bkeegs/Mixtape-Board/mixtape_layout.PNG

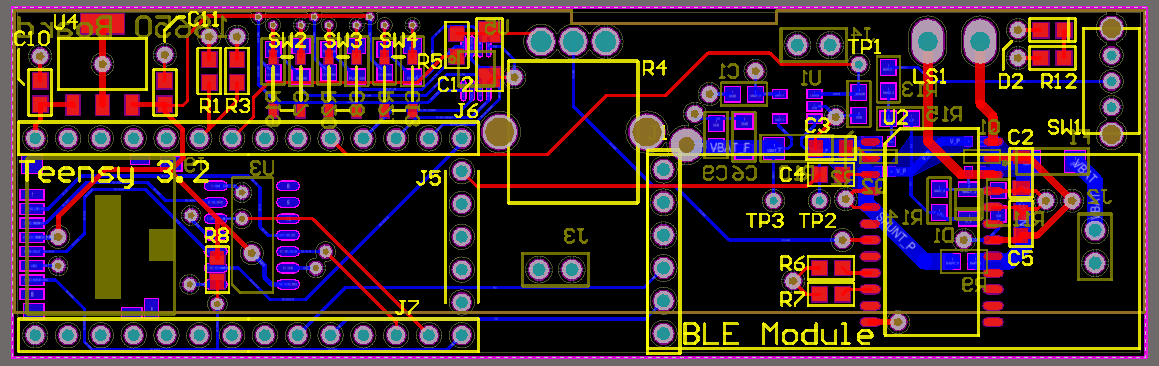
mixtape_layout.PNG
