bkeegs/Mixtape-Board/PDF_and_BOM/mixtape_BOM.xlsx

Description | Designator | LibRef | Manufacturer 1 | Manufacturer Part Number 1 | Quantity | Supplier Part Number 1
CAP CER 0.1UF 16V X7R 0603 | C1, C5 | CC0603KRX7R7BB104 | Yageo | CC0603KRX7R7BB104 | 2 | 311-1088-1-ND
CAP CER 10UF 25V X5R 0805 | C2, C6, C7, C8, C13 | GRM21BR61E106KA73L | Murata Electronics North America | GRM21BR61E106KA73L | 5 | 490-5523-1-ND
CAP CER 2.2UF 10V X7R 0805 | C3 | C0805C225K8RACTU | Kemet | C0805C225K8RACTU | 1 | 399-3522-1-ND
CAP CER 1UF 25V X5R 0603 | C4, C10, C11 | CL10A105KA8NNNC | Samsung Electro-Mechanics America, Inc. | CL10A105KA8NNNC | 3 | 1276-1102-1-ND
CAP CER 100PF 25V NP0 0201 | C9 | GRM0335C1E101JA01D | Murata Electronics North America | GRM0335C1E101JA01D | 1 | 490-3160-1-ND
CAP CER 100UF 6.3V X6T 1206 | C12 | GRM31CD80J107ME39L | Murata Electronics North America | GRM31CD80J107ME39L | 1 | 490-10525-1-ND
DIODE ZENER 3V 200MW SMINI2 | D1 | DZ2J030M0L | Panasonic Electronic Components | DZ2J030M0L | 1 | DZ2J030M0LCT-ND
LED GREEN CLEAR 0603 SMD | D2 | LTST-C191KGKT | Lite-On Inc. | LTST-C191KGKT | 1 | 160-1446-2-ND
FUSE BOARD MOUNT 3A 125VAC 63VDC | F1 | C1Q 3 | Bel Fuse Inc. | C1Q 3 | 1 | 507-1082-1-ND
CONN HEADER FEMALE 6POS .1" TIN | J1 | PPTC061LFBN-RC | Sullins Connector Solutions | PPTC061LFBN-RC | 1 | S7004-ND
CONN HEADER VERT SGL 2POS GOLD | J2, J3, J4 | 961102-6404-AR | 3M | 961102-6404-AR | 3 | 3M9447-ND
SOCKET 7 MM SOLDER TAIL SINGLE | J5 | HEADER TEENSY B | Preci-Dip | 801-87-005-10-001101 | 1 | 1212-1183-ND
SOCKET 7 MM SOLDER TAIL SINGLE | J6 | HEADER TEENSY C | Preci-Dip | 801-87-014-10-001101 | 1 | 1212-1201-ND
SOCKET 7 MM SOLDER TAIL SINGLE | J7 | HEADER TEENSY A | Preci-Dip | 801-87-014-10-001101 | 1 | 1212-1201-ND
CONN MICRO SD CARD PUSH-PULL | J9 | DM3D-SF | Hirose Electric Co Ltd | DM3D-SF | 1 | HR1941CT-ND
SPEAKER 4 OHM 3W 86DB 71X41MM | LS1 | AS07104PO-R | PUI Audio, Inc. | AS07104PO-R | 1 | 668-1216-ND
MOSFET P-CH 20V 8A 6-TSOP | Q1, Q2 | SI3407DV-T1-GE3 | Vishay Siliconix | SI3407DV-T1-GE3 | 2 | SI3407DV-T1-GE3CT-ND
RES SMD 49.9K OHM 1% 1/10W 0603 | R1 | RC0603FR-0749K9L | Yageo | RC0603FR-0749K9L | 1 | 311-49.9KHRCT-ND
RES SMD 100K OHM 1% 1/10W 0603 | R2, R11, R14, R15 | RC0603FR-07100KL | Yageo | RC0603FR-07100KL | 4 | 311-100KHRCT-ND
RES SMD 120K OHM 1% 1/10W 0603 | R3 | RC0603FR-07120KL | Yageo | RC0603FR-07120KL | 1 | 311-120KHRCT-ND
POT 20K OHM 1/20W CARBON LOG | R4 | PTV09A-4025F-A203 | Bourns Inc. | PTV09A-4025F-A203 | 1 | PTV09A-4025F-A203-ND
RES SMD 499 OHM 1% 1/10W 0603 | R5 | RC0603FR-07499RL | Yageo | RC0603FR-07499RL | 1 | 311-499HRCT-ND
RES SMD 4.99K OHM 1% 1/10W 0603 | R6, R7 | ERJ-3EKF4991V | Panasonic Electronic Components | ERJ-3EKF4991V | 2 | P4.99KHCT-ND
RES SMD 10K OHM 5% 1/10W 0603 | R8 | RC0603JR-0710KL | Yageo | RC0603JR-0710KL | 1 | 311-10KGRCT-ND
RES SMD 0.0OHM JUMPER 1/10W 0603 | R9 | RC0603JR-070RL | Yageo | RC0603JR-070RL | 1 | 311-0.0GRCT-ND
RES SMD 0.02 OHM 1% 1W 1206 | R10 | ERJ-8CWFR020V | Panasonic Electronic Components | ERJ-8CWFR020V | 1 | P0.02BVCT-ND
RES SMD 110 OHM 1% 1/10W 0603 | R12 | RC0603FR-07110RL | Yageo | RC0603FR-07110RL | 1 | 311-110HRCT-ND
RES SMD 3.3K OHM 1% 1/10W 0603 | R13, R19, R20, R21 | RC0603FR-073K3L | Yageo | RC0603FR-073K3L | 4 | 311-3.30KHRCT-ND
SWITCH SLIDE SPDT 100MA 12V | SW1 | OS102011MA1QN1 | C&K Components | OS102011MA1QN1 | 1 | CKN9559-ND
SWITCH TACTILE SPST-NO 0.05A 16V | SW2, SW3, SW4 | PTS810 SJM 250 SMTR LFS | C&K | PTS810 SJM 250 SMTR LFS | 3 | CKN10502CT-ND
IC CURRENT MONITOR 0.5% SOT23-5 | U1 | INA138NA/250 | Texas Instruments | INA138NA/250 | 1 | INA138NACT-ND
IC AMP AUDIO SO24 | U2 | PAM8009DHR | Diodes Incorporated | PAM8009DHR | 1 | PAM8009DHRDICT-ND
IC BUS BUFF TRI-ST QD 14SOIC | U3 | SN74LVC125ADR | Texas Instruments | SN74LVC125ADR | 1 | 296-8453-1-ND
IC REG LDO 3.3V 0.5A SOT-223-3 | U4 | MCP1825ST-3302E/DB | Microchip Technology | MCP1825ST-3302E/DB | 1 | MCP1825ST-3302E/DBCT-ND
IC TRPL SCHMT-TRIGG INVERT SM8 | U5 | SN74LVC3G14DCTR | Texas Instruments | SN74LVC3G14DCTR | 1 | 296-13284-1-ND
