bkeegs/Mixtape-Board/PDF_and_BOM/mixtape_sch.pdf

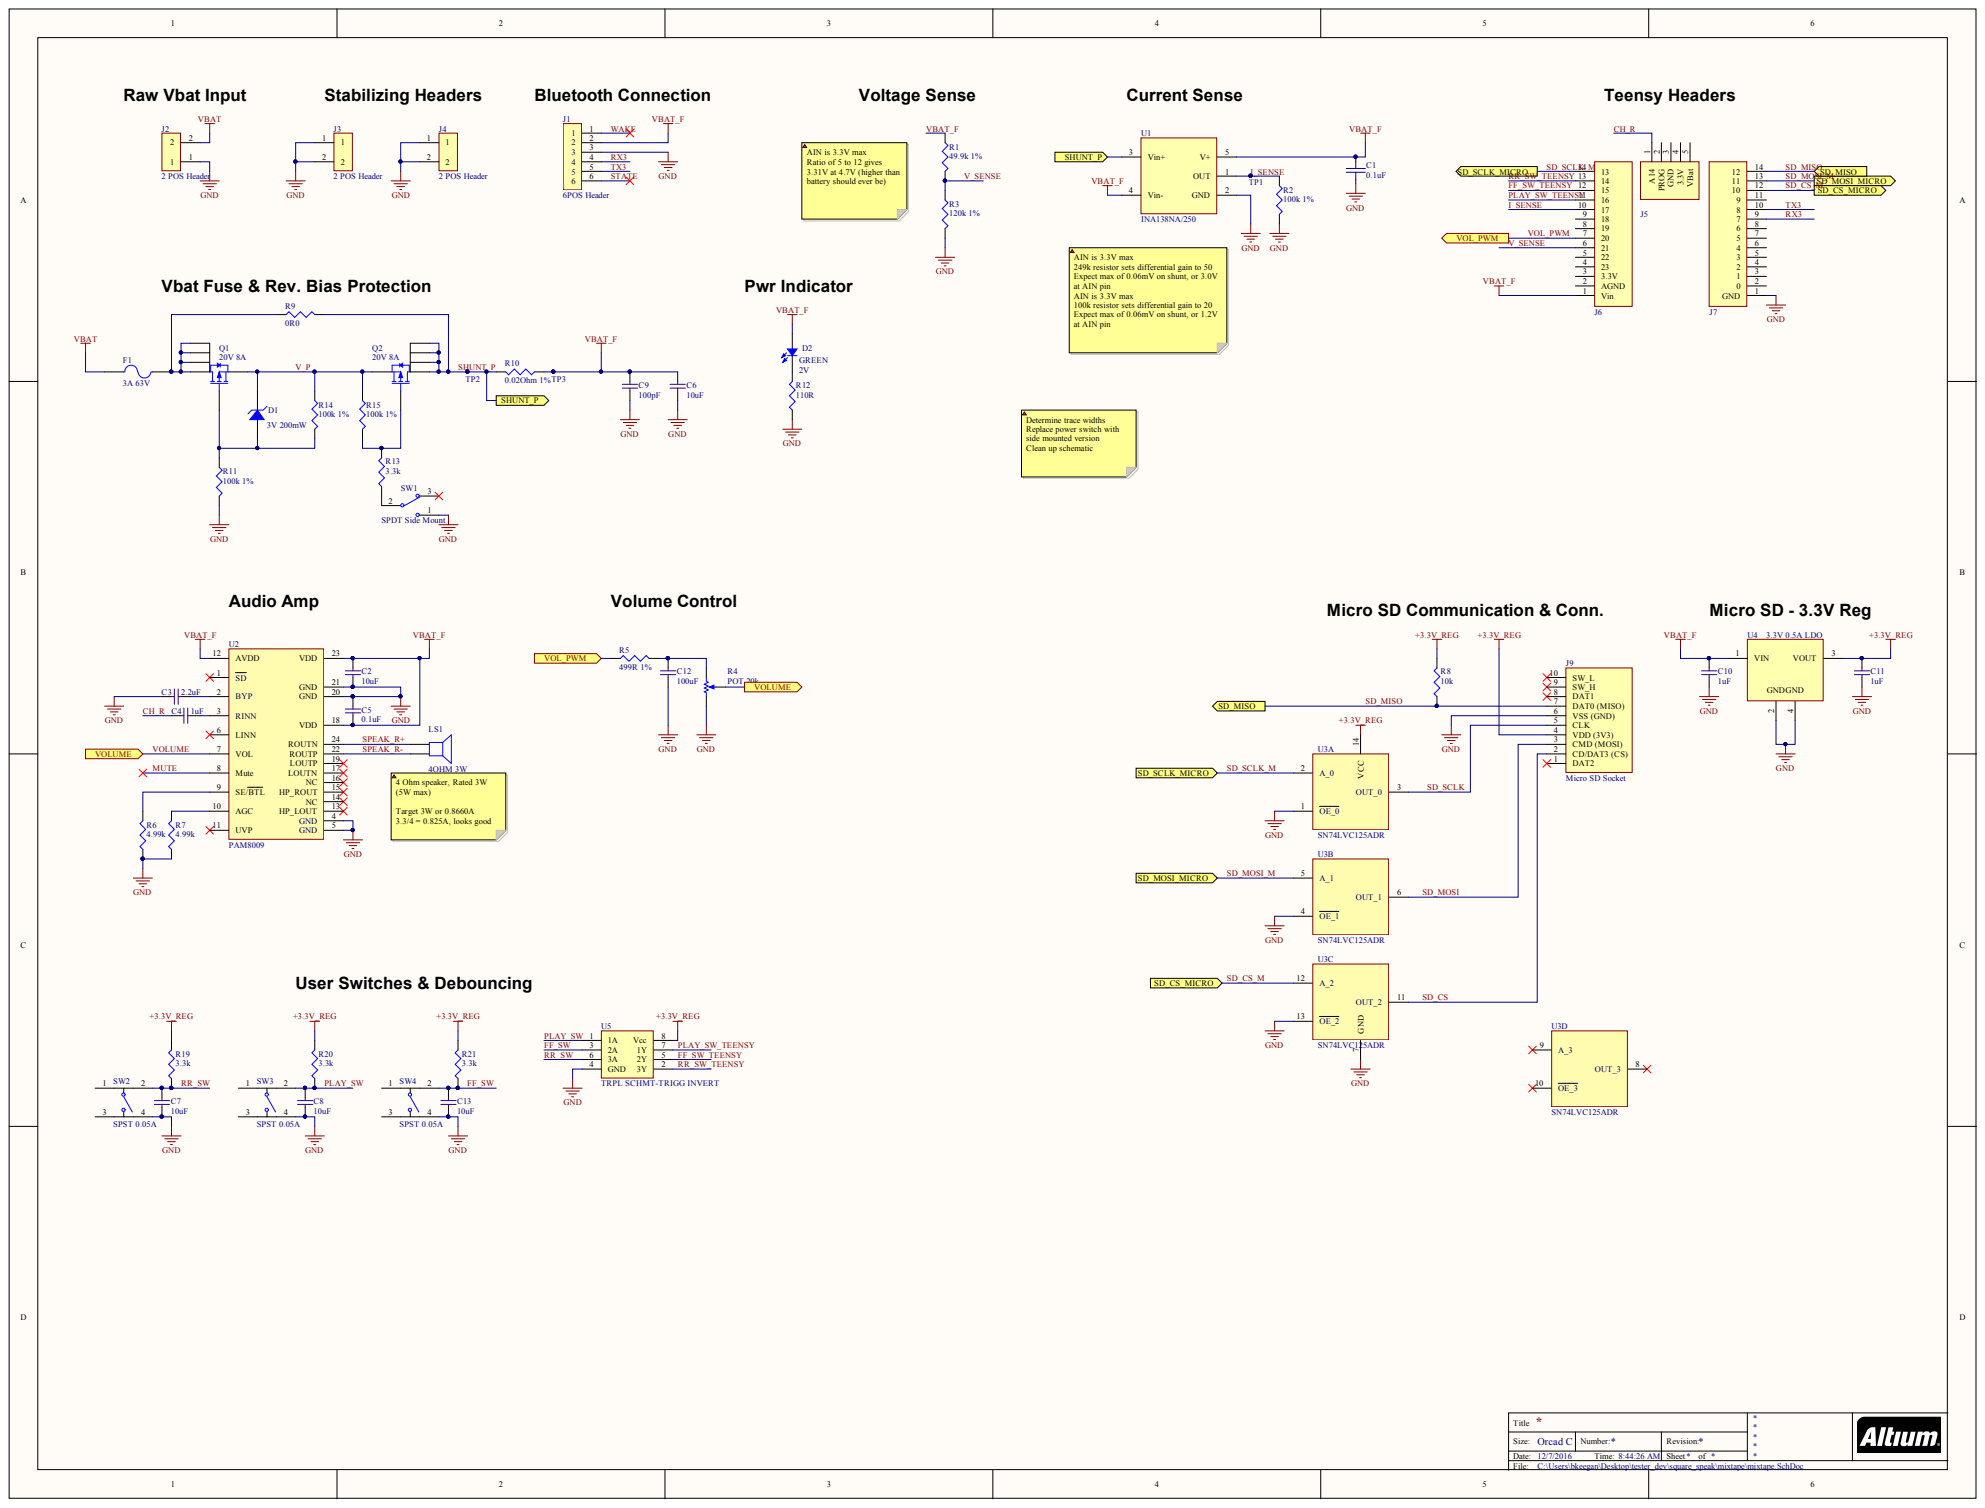
[picture p5: page 1]

AIN is 3.3V max
Ratio of 5 to 12 gives
3.31V at 4.7V (higher than
battery should ever be)

249k resistor sets differential gain to 50
Expect max of 0.06mV on shunt, or 3.0V
at AIN pin
100k resistor sets differential gain to 20
Expect max of 0.06mV on shunt, or 1.2V

Vbat Fuse & Rev. Bias Protection

Determine trace widths
Replace power switch with
side mounted version
Clean up schematic

Micro SD Communication & Conn.

Micro SD Socket 4 Ohm speaker, Rated 3W
(5W max)

TRPL SCHMT-TRIGG INVERT

* Title | * * * * *

Size: Orcad C | Number: * | Revision: *

Date: 12/7/2016 Time: 8:44:26 AM | | Sheet * of *

C:\Users\bkeegan\Desktop\tester_dev\square_speak\mixtape\mixtape.SchDoc
