bkeegs/Mixtape-Board/(commit log)

2016-12-07 added PDF and BOM
    [mixtape_BOM.xlsx]
2017-02-02 Update README.md
    Updating to reflect board was built and is working
2017-03-06 adding teensy code
